lfoliveira08/plant-watering-esp32/docs/Project1_Code_and_Sensor_Guide.docx

ENGR 4399 ST: Cyber-Physical and IoT Systems

Project 1: Code and Sensor Guide

Automatic Plant Watering System with weather-aware dashboard

A plain-language walkthrough of the hardware, the sensors and every part of the ESP32 program, with real excerpts from the code and worked examples. Written so a teammate who did not write the code can explain it and answer questions at the presentation.

Built by: Luis Oliveira Presenting: [partner name] Instructor: Dr. Okan Çağlayan Date: October 20, 2026

HOW TO USE THIS GUIDE

Part 1 is the story in one page. Read it first and you can present the project.

Part 2 explains each sensor and part. Part 3 walks through the code in the order the program runs. Part 4 follows full scenarios with timelines. Part 5 is a question-and-answer sheet. Part 6 is a glossary.

Green boxes give you words to say out loud. Orange boxes are worked examples. Grey boxes are real code from the file RealHardware_Dashboard.ino.

Contents

- Part 1: The project in one page
- Part 2: The hardware and sensors explained
- Part 3: The code, section by section
- Part 4: Worked scenarios (timelines)
- Part 5: Questions you may be asked
- Part 6: Glossary and quick reference

# Part 1: The project in one page

## What it does

A small ESP32 computer reads how wet the soil is. When the soil is too dry, it turns on a pump through a relay and waters the plant. It then waits for the water to spread, checks that the soil actually got wetter, and stops. It will not water if the tank is empty (the pump would run dry) or if rain is coming (the rain will water the plant). It shows its status on a small screen and on a web dashboard, and a buzzer warns if the temperature is bad for the plant.

SAY IT LIKE THIS

“Our system is a small cyber-physical system. It senses the soil moisture and the water level, decides using a state machine, and acts by switching a pump. On top of that it checks the weather forecast, judges the temperature for the selected plant, and has a dashboard with simulation buttons so we can show every safety behavior live.”

## The idea came from a video, and we extended it

The basic concept (soil sensor, relay and small pump) is inspired by the Instagram video “Automatic Plant Watering System” by eazytronic3795. We say this out loud and it is in the report. What we added:

- Tank-level interlock so the pump never runs dry
- Hysteresis (start and stop thresholds), an 8-second pump limit and a soak wait
- Response check and a FAULT latch if the pump or sensor seems broken
- Weather forecast: skip watering if rain is likely
- Three plant profiles: how much water each plant wants and its healthy temperature range
- Temperature alert on the screen, dashboard and buzzer
- A web dashboard with five simulation buttons

## The five-step loop, every half second

1. Read the soil sensor and the water-level sensor (averaged to remove noise).
2. Convert the soil reading to a percentage using the calibration.
3. Decide with the state machine: IDLE, WATERING, SOAKING or FAULT.
4. Act: switch the relay (pump) and the buzzer.
5. Show: update the OLED screen and answer dashboard requests.

## Numbers worth remembering

Item | Value
Soil sensor reading | about 0 in air, about 1500 in water (reads LOW when dry)
Soil percent | raw value divided by 15 (1500 raw = 100%)
Basil / Aloe / Fern: start watering below | 40% / 15% / 50%
Basil / Aloe / Fern: stop at | 70% / 35% / 80%
Tank is LOW below | raw 300 (counts as refilled above 450)
Longest pump run | 8 seconds (BOOT button test: 5 seconds)
Soak wait (demo) | 30 seconds
Fault | after 3 failed cycles, cleared only by pressing EN
Rain blocks watering at | 60% rain chance or more in the next 3 hours
Weather refresh | every 10 minutes
Relay | ACTIVE-HIGH: pin HIGH = relay ON

# Part 2: The hardware and sensors explained

## 2.1 Two ideas you need first

### Sensors and actuators

A sensor measures the physical world and turns it into an electrical signal (soil moisture, water level). An actuator does something in the physical world when told to (the pump, the buzzer). The ESP32 sits in the middle: it reads sensors, decides, and drives actuators. That loop of sensing, deciding and acting on the physical world is what “cyber-physical” means.

### Analog readings and the ADC

Our two sensors give an analog signal, a voltage that changes smoothly. The ESP32 cannot use a voltage directly, so its ADC (analog-to-digital converter) turns it into a number. We use 12-bit resolution, which means numbers from 0 to 4095 for a voltage from about 0 V to 3.3 V. In the code this is the line analogReadResolution(12); in setup().

EXAMPLE

A raw reading of 1500 is about 1500 / 4095 x 3.3 V = 1.2 V. A raw reading of 0 is about 0 V.

The ESP32’s ADC is not perfectly straight, so we do not trust a formula from a data sheet. We calibrate with real readings: sensor in air, sensor in water, and write those numbers in the code.

### Why the sensor pins are D34 and D35

The ESP32 has two ADC groups. ADC2 stops working while Wi-Fi is on. ADC1 (pins 32 to 39) keeps working. D34 and D35 are ADC1, and they are input-only, which is fine for sensors. We use Wi-Fi for the weather and dashboard, so this choice matters.

## 2.2 Soil moisture sensor (Keyestudio, resistive)

Item | Detail
What it is | A small board with two exposed metal probes (prongs) that go into the soil
Pins | S = signal, V = power, G = ground (printed under the pins)
Our wiring | S to D34, V to 3V3, G to GND
Output type | Analog voltage, read by the ADC
Measured values | About 0 in air, about 1500 in water

### How it works

Wet soil conducts electricity better than dry soil. The two probes act like a variable resistor: more water means less resistance between them. The board turns that into a voltage on the signal pin. More water gives a higher voltage and a higher number.

SAY IT LIKE THIS

“The probe measures how easily electricity flows through the soil between two prongs. Water makes that easier, so wetter soil gives a higher reading.”

### The lesson: this sensor reads LOW when dry

Many tutorials use the YL-69 sensor, which reads high when dry. Ours is the opposite: about 0 in air and about 1500 in water. Code copied from those tutorials would be backwards. We avoided this by measuring our own two points and converting with them:

static const int SOIL_RAW_DRY = 0;

static const int SOIL_RAW_WET = 1500;

static float soilPercentFromRaw(int raw) {

float pct = 100.0f * (raw - SOIL_RAW_DRY) / (float)(SOIL_RAW_WET - SOIL_RAW_DRY);

return constrain(pct, 0.0f, 100.0f);

}

Code: calibration constants and the raw-to-percent function.

EXAMPLE

Raw 750 → 100 x (750 − 0) / (1500 − 0) = 50%

Raw 300 → 20%. Raw 1500 → 100%. Raw 1800 (probe in very wet soil) → 130%, which constrain() cuts to 100%.

Because the formula uses the dry and wet numbers, it would still work for a sensor that reads the other way (dry number larger than the wet number).

### Limits to mention honestly

- Resistive probes corrode over time, especially if powered all the time. A capacitive probe lasts longer (future work).
- Readings depend on soil type and salts, so the percent is a useful guide, not a lab measurement.
- Wet soil reads lower than a glass of water. The 100% is “probe in water,” so a healthy wet pot may read 60 to 80%, which is why the thresholds are tunable per plant.

## 2.3 Water level sensor (Keyestudio)

Item | Detail
What it is | A board with a row of parallel exposed traces; the more of them are under water, the higher the reading
Pins | S = signal, V = power, G = ground
Our wiring | S to D35, V to 3V3, G to GND
Output type | Analog, read by the ADC (no on/off output)
Measured values | About 0 when dry; tank counts as LOW below raw 300

It works on the same principle as the soil sensor: water bridges the traces and changes the signal. We mount it standing in the tank with its lowest trace a little above the pump. When the water drops below the sensor, the reading falls under 300 and the tank is LOW, which blocks the pump before it can run dry.

### Hysteresis on the tank

Water ripples and the reading wobbles. If we used one cut-off, the tank status could flicker between OK and LOW. So we use two: LOW below 300, but only OK again above 300 + 150 = 450.

static const int LEVEL_LOW_RAW = 300;

static const int LEVEL_HYST_RAW = 150;

if (levelRaw < LEVEL_LOW_RAW) realTankLow = true;

else if (levelRaw > LEVEL_LOW_RAW + LEVEL_HYST_RAW) realTankLow = false;

tankLow = realTankLow || simTank;

Code: tank threshold with hysteresis. The last line combines the real tank with the dashboard simulation.

EXAMPLE

Water falls: 520 → 380 → 290 (now LOW) → 320 (still LOW) → 420 (still LOW).

Refill: 460 (above 450 → OK again).

Readings between 300 and 450 keep whatever status was already set.

## 2.4 Relay module (Elegoo, 1 channel, 5 V)

The ESP32 pins give only a tiny current and 3.3 V, far too little to run a pump. A relay is an electrically controlled switch: a small signal from the ESP32 magnetizes a coil, which closes a separate switch (the contacts) that carries the pump current. The two circuits are electrically separate, so the pump supply never flows through the ESP32.

Relay part | Connected to | Purpose
Header S (signal) | D26 | The ESP32 tells the relay on or off
Header + / − | VIN (5 V) / GND | Power for the relay coil and its board
Screw COM (common) | Pump supply (+) | Incoming power for the pump
Screw NO (normally open) | Pump red wire | Open when the relay is off, closed when on
Pump black wire | Pump supply (−) | Return path of the pump circuit

We use NO (normally open) so that when the relay is off or the ESP32 is unpowered, the pump is off. That is the safe default.

### Active-HIGH vs active-LOW (our lesson)

Some relay modules turn on when the pin is LOW (active-low), others when it is HIGH (active-high). We first assumed active-low, as many blue modules are. A small test sketch with the pump disconnected showed ours is active-HIGH. The code has a setting for this so one line adapts it:

static const bool RELAY_ACTIVE_LOW = false; // measured: this relay is ACTIVE-HIGH

static void relayWrite(bool on) {

if (RELAY_FLOAT_WHEN_OFF && RELAY_ACTIVE_LOW) {

// (open-drain option for other relay modules)

}

pinMode(PIN_RELAY, OUTPUT);

bool level = RELAY_ACTIVE_LOW ? !on : on;

digitalWrite(PIN_RELAY, level ? HIGH : LOW);

}

Code: relayWrite() turns “on” or “off” into the right pin level for this relay.

EXAMPLE

relayWrite(true) with RELAY_ACTIVE_LOW = false → level = true → pin HIGH → relay clicks ON → pump runs.

If the relay had been active-low: level = !on = false → pin LOW. The rest of the program never needs to know.

## 2.5 Submersible pump

A small DC motor sealed so it can run underwater, with a tube to the plant. It must be fully under water while running (water also cools it). It runs from its own supply through the relay. Do not run it dry: that is the reason for the water-level sensor and the 8-second limit.

## 2.6 OLED display (SSD1306, 0.96 inch, I2C)

A 128 by 64 pixel screen. I2C is a two-wire bus: SDA carries data and SCL carries the clock. Many devices can share the same two wires, each with an address; this one is 0x3C. Wiring: SDA to D21, SCL to D22, VCC to 3V3, GND to GND. The code uses the Adafruit SSD1306 and GFX libraries to draw text and shapes.

Row (pixel y) | What is drawn
0 | Plant profile name (left) and temperature (right)
11 | “Soil NN%” in large text
30 to 38 | Moisture bar with two tick marks (start and stop thresholds) below it at y 40
45 | State and pump: e.g. “IDLE Pump:off”
56 | Most important message: FAULT, TANK LOW, RAIN, TEMP alert, CHECK PUMP, or “Tank OK”

## 2.7 Active buzzer

An active buzzer has its own tone generator inside: apply power and it beeps. So the code only switches it on and off (one pin, D27). A passive buzzer would need us to generate the tone. We make two different alert sounds by changing the on/off pattern (explained in Part 3).

## 2.8 BOOT button

The ESP32 board has a BOOT button wired to pin 0. We reuse it as a manual pump test: hold it and the pump runs for up to 5 seconds, only if the tank has water. It is wired with INPUT_PULLUP, so the pin reads HIGH normally and LOW when pressed. Do not hold it while pressing EN or the board enters upload mode.

## 2.9 The ESP32 and the “virtual sensor”

The ESP32 is a small computer with Wi-Fi. It runs the program, reads the sensors, drives the relay and buzzer, joins Wi-Fi, fetches the weather and serves the dashboard. The weather forecast works like a third sensor: it tells the program the outdoor temperature and the rain chance, even though no physical device measures it.

## 2.10 Pin summary

ESP32 pin | Connected to | Direction | Why this pin
D34 | Soil sensor S | Input (analog) | ADC1, works with Wi-Fi
D35 | Level sensor S | Input (analog) | ADC1, works with Wi-Fi
D26 | Relay signal | Output | Safe general-purpose pin
D27 | Buzzer | Output | General-purpose pin
D21 / D22 | OLED SDA / SCL | I2C | Default I2C pins
D0 | BOOT button | Input (pull-up) | Built into the board
3V3 | Sensors, OLED power | Power | Sensors are 3.3 V logic
VIN (5 V) | Relay module power | Power | Relay coil needs 5 V

# Part 3: The code, section by section

The file RealHardware_Dashboard.ino is about 570 lines. It reads top to bottom in this order: settings, data, helper functions, weather, dashboard, network, display, control logic, then setup() and loop(). The excerpts below are copied from the real file.

## 3.1 The big picture: setup() once, loop() forever

Every Arduino program has two main functions. setup() runs once at power-up. loop() then repeats forever. Our loop() never waits with delay(). Instead it keeps checking the clock (millis(), milliseconds since power-up) and does each job when its time comes. This is called non-blocking design: the web page stays responsive while the pump logic runs.

void loop() {

static uint32_t lastSample = 0;

static int lastRelay = -1;

uint32_t now = millis();

server.handleClient();

updatePrime(now);

if (now - lastSample >= SAMPLE_MS) { lastSample = now; sampleAndControl(now); }

// ...

updateAlert(now);

// ...

}

Code: loop() in outline. Sensors and control run every SAMPLE_MS = 500 ms; the web server and buzzer are serviced on every pass.

SAY IT LIKE THIS

“The program never freezes waiting. Every half second it reads the sensors and runs the decision logic, and in between it keeps answering the web dashboard and the buzzer.”

## 3.2 Libraries (the #include lines)

Library | What we use it for
Wire.h | I2C communication with the OLED
WiFi.h | Join the router or create our own network
WebServer.h | Serve the dashboard page and its small API
ESPmDNS.h | Lets you type plantwater.local instead of an IP address
HTTPClient.h | Ask the weather service for data
Adafruit_GFX.h, Adafruit_SSD1306.h | Draw text and shapes on the OLED

## 3.3 Settings you can change (the constants)

All behavior numbers are in one block at the top so nothing is buried in the logic. static const means the value cannot change while the program runs.

static const int RAIN_SKIP_PCT = 60;

static const uint32_t MAX_RUN_MS = 8000;

static const uint32_t SOAK_MS = 30000;

static const float MIN_RISE_PCT = 3.0f;

static const int MAX_FAILED_CYCLES = 3;

static const uint32_t PRIME_MAX_MS = 5000;

static const uint32_t SAMPLE_MS = 500;

Code: the main tuning constants. Times are in milliseconds.

Constant | Meaning | Change it when
RAIN_SKIP_PCT | Rain chance at or above this blocks watering | You want the system more or less cautious about rain
MAX_RUN_MS | Longest single pump run (8 s) | A bigger pot needs a longer run
SOAK_MS | Wait after a run for water to reach the probe (30 s demo) | A real plant: use minutes
MIN_RISE_PCT | Soil must rise this much after a run, or the run counts as failed | Soil responds slowly or quickly
MAX_FAILED_CYCLES | Failed runs before FAULT | Stricter or more forgiving
PRIME_MAX_MS | BOOT button pump limit | Rarely
SAMPLE_MS | How often sensors are read | Rarely

## 3.4 Plant profiles

A struct groups related values into one record. Each profile holds a name, a description, the soil percent to start watering, the percent to stop, and the healthy temperature range. PROFILES[3] is a list of three of them, and profileIdx says which one is selected (0 = Basil).

struct Profile { const char* name; const char* need; float dry; float wet; float tMin; float tMax; };

static const Profile PROFILES[3] = {

{ "Basil", "thirsty", 40.0f, 70.0f, 12.0f, 32.0f },

{ "Aloe", "drought-tolerant", 15.0f, 35.0f, 10.0f, 35.0f },

{ "Fern", "likes moist soil", 50.0f, 80.0f, 16.0f, 27.0f },

};

static uint8_t profileIdx = 0;

static float curDry() { return PROFILES[profileIdx].dry; }

static float curWet() { return PROFILES[profileIdx].wet; }

Code: three profiles and helpers that return the values of the selected one.

EXAMPLE

With Basil selected, watering starts below 40% (raw below 600) and stops at 70% (raw 1050).

Press Aloe on the dashboard: profileIdx becomes 1, so curDry() returns 15 and curWet() returns 35. Nothing else in the code changes, because the logic always asks curDry() and curWet().

To use your own plants, edit the names and numbers in this one table.

## 3.5 State variables: real values and simulated values

The program keeps its current knowledge in variables. The most important is the state (what the system is doing). Notice that for tank, rain, soil and temperature there is a real value and a simulation switch. This is what lets the dashboard buttons override reality without touching the control logic.

enum State : uint8_t { IDLE, WATERING, SOAKING, FAULT };

static State state = IDLE;

static bool realTankLow = false;

static bool tankLow = false; // real OR simulated

static float soilReal = 0, soilShown = 0;

static bool simRain = false, simTank = false, simSoil = false;

static uint8_t simTemp = 0; // 0 off, 1 too high, 2 too low

Code: the state and the simulation switches.

State | Meaning
IDLE | Soil is fine, or soil is dry but something blocks watering
WATERING | Pump is on
SOAKING | Pump is off while water spreads to the probe
FAULT | Pump disabled after repeated failures; only the EN reset clears it

## 3.6 Helper functions

### readAveraged(): smoothing the noise

A single ADC reading jumps around a little. We read many times quickly and take the average (16 readings for soil, 8 for the tank). This is a simple low-pass filter.

static int readAveraged(int adcPin, int samples) {

long acc = 0;

for (int i = 0; i < samples; i++) { acc += analogRead(adcPin); delayMicroseconds(200); }

return (int)(acc / samples);

}

Code: add up the readings and divide by how many.

EXAMPLE

Four readings 748, 752, 751, 749 add up to 3000; 3000 / 4 = 750, which is 50% soil. One bad spike of 900 would be softened to about 782 instead of jumping straight to 60%.

### Effective values: where simulations are applied

Instead of using the real values directly, the logic asks for the “effective” value: the simulated one if a simulation is on, otherwise the real one.

static float effectiveTemp() {

if (simTemp == 1) return curTMax() + 8.0f;

if (simTemp == 2) return curTMin() - 8.0f;

return weatherTemp;

}

static int effectiveRain() { return simRain ? 100 : weatherRain; }

static bool rainBlock() { int r = effectiveRain(); return r >= RAIN_SKIP_PCT; }

// 0 unknown, 1 OK, 2 too high, 3 too low

static uint8_t tempStatus() {

float t = effectiveTemp();

if (isnan(t)) return 0;

if (t > curTMax()) return 2;

if (t < curTMin()) return 3;

return 1;

}

Code: effective temperature, rain and the temperature verdict.

EXAMPLE

Basil is selected (healthy 12 to 32 °C). “Temp too high” simulated → effective temperature = 32 + 8 = 40 °C → tempStatus() returns 2 (too high) → alert.

Real weather 27 °C → returns 1 (OK). No weather data yet (NaN) → returns 0 (unknown), so no false alarm.

Rain simulated → effectiveRain() = 100 → rainBlock() true. Real forecast 20% → false.

### setState() and the event log

Every change of state goes through setState(), which writes a line to the Serial Monitor and to a small ring buffer of the last 8 events that the dashboard shows. It also records the time of the change, so the program can measure how long it has been in a state.

static void setState(uint8_t s, const char* why) {

char b[80];

snprintf(b, sizeof b, "%s -> %s: %s", STATE_NAME[state], STATE_NAME[s], why);

logEvent(b);

state = (State)s;

stateSince = millis();

}

Code: one place where the state changes and is recorded.

EXAMPLE

Dashboard event log line: IDLE -> WATERING: soil dry. This is how you can explain to the audience exactly why something happened.

## 3.7 Weather: fetchWeather()

The ESP32 sends a web request to the free Open-Meteo service. The reply is text in a format called JSON. Instead of a heavy JSON library, we search for two known labels in the text and read the number after each. If Wi-Fi is not connected, the function does nothing.

String url = String("http://api.open-meteo.com/v1/forecast?latitude=") + LATITUDE + "&longitude=" + LONGITUDE +

"&current=temperature_2m&hourly=precipitation_probability&forecast_hours=3&timezone=auto";

HTTPClient http;

http.setTimeout(4000);

http.begin(url);

int code = http.GET();

Code: building the request. It asks for the current temperature and the rain probability for the next 3 hours at our latitude and longitude.

A simplified picture of the reply, and how the code reads it:

{ ... "current":{"time":"...","interval":900,"temperature_2m":27.4},

... "hourly":{"time":[...],"precipitation_probability":[10,20,35]} }

Shape of the answer (example values).

int c = body.indexOf("\"current\":{");

if (c >= 0) {

int t = body.indexOf("\"temperature_2m\":", c);

if (t >= 0) { weatherTemp = body.substring(t + 17).toFloat(); ok = true; }

}

Code: find “current”, then “temperature_2m” after it, then read the number that follows (17 characters later).

while (i < (int)body.length() && body[i] != ']') {

if (isDigit(body[i])) { int v = body.substring(i).toInt(); if (v > best) best = v; while (isDigit(body[i])) i++; }

else i++;

}

Code: walk through the three rain percentages and keep the largest (“best”).

EXAMPLE

Reply says rain probability [10,20,35] → the code keeps 35. If it were [10,20,70], it keeps 70, which is at or above 60, so rainBlock() becomes true.

Why the maximum? If rain is likely at any point in the next 3 hours, watering now is wasteful.

Schedule: after a good reply the next request is in 10 minutes (600000 ms); after a failure, in 30 seconds. In loop(), weather is fetched only when the pump is not running, because a request can block for a few seconds and we never want the network to delay the pump limits.

SAY IT LIKE THIS

“Every ten minutes the ESP32 asks a free weather service for the temperature and the rain chance. If rain is likely, the pump is blocked, because the rain will water the plant.”

## 3.8 The dashboard: a web page served by the ESP32

The ESP32 is a tiny web server. When your phone or laptop opens plantwater.local, the ESP32 sends back one HTML page that is stored inside the program (the long block named PAGE). That page contains JavaScript that, once per second, asks the ESP32 for the latest status and redraws the screen. Buttons call small web addresses (the API) to change things.

Address | What it does
/ | Sends the dashboard page
/api/status | Returns all current values as JSON (soil, state, pump, tank, rain, temperature, profile, events, simulation flags)
/api/sim?name=rain&val=1 | Turns a simulation on or off (names: rain, tank, soil, temp, clear)
/api/profile?id=1 | Selects a plant profile
/api/mute | Silences the buzzer
/api/weather | Asks for a weather refresh now

refresh();setInterval(refresh,1000);

static void handleSim() {

String n = server.arg("name");

int v = server.arg("val").toInt();

if (n == "clear") { simRain = simTank = simSoil = false; simTemp = 0; logEvent("SIM: all simulations cleared"); }

else if (n == "rain") { simRain = v; logEvent(v ? "SIM: heavy rain forecast injected" : "SIM: rain forecast cleared"); }

// ... tank, soil, temp work the same way

server.send(200, "text/plain", "ok");

}

Code: the page refreshes every second (line 1); handleSim() receives a button press.

EXAMPLE

You press Rain forecast. Chain of events:

1. The browser calls /api/sim?name=rain&val=1.

2. handleSim() sets simRain = true and logs an event.

3. Within half a second, sampleAndControl() sees rainBlock() is true. If the pump is running, the state goes WATERING → IDLE, and the relay is switched off in loop().

4. The next /api/status reply says rainblock:true, and the dashboard shows “BLOCKED - rain will water it”.

NOTE FOR QUESTIONS

The simulations only change what the program believes about rain, tank, soil and temperature. They cannot turn off the 8-second limit, the tank interlock or the fault latch. The dashboard has no password and uses plain HTTP, which is fine for a classroom demo but would need a login and HTTPS in a real product.

## 3.9 Joining Wi-Fi: startNetwork()

At power-up the ESP32 tries to join the router for up to 12 seconds. If that fails, it creates its own Wi-Fi network called “PlantWater” so the dashboard is still reachable (at 192.168.4.1), but weather is then unavailable and only the simulations work. It also registers the name plantwater.local, which is why that address worked even when the IP address changed.

WiFi.mode(WIFI_STA);

if (strlen(WIFI_SSID) > 0) {

WiFi.begin(WIFI_SSID, WIFI_PASS);

uint32_t t0 = millis();

while (WiFi.status() != WL_CONNECTED && millis() - t0 < WIFI_TIMEOUT_MS) { delay(300); Serial.print("."); }

}

if (WiFi.status() == WL_CONNECTED) {

ipText = WiFi.localIP().toString();

apMode = false;

} else {

WiFi.disconnect(); WiFi.mode(WIFI_AP);

WiFi.softAP(AP_SSID, AP_PASS);

apMode = true;

}

if (MDNS.begin("plantwater")) Serial.println("Also reachable at http://plantwater.local");

Code: try the router, fall back to our own network, register the plantwater.local name.

SAY IT LIKE THIS

“If the Wi-Fi is not available, the system does not fail. It creates its own network so we can still use the dashboard and the simulations.”

## 3.10 Manual pump test: updatePrime()

static void updatePrime(uint32_t now) {

static uint32_t start = 0;

static bool held = false;

if (digitalRead(PIN_PRIME) == LOW) {

if (!held) {

held = true; start = now;

}

primeOn = !tankLow && (now - start < PRIME_MAX_MS);

} else { held = false; primeOn = false; }

}

Code: while BOOT is pressed the pump may run, up to 5 seconds, and never with a low tank.

held remembers that the press already started, so the 5 seconds are counted from the first moment, not from every pass of the loop. Releasing the button resets it.

## 3.11 The screen: drawScreen()

The OLED is redrawn after each sample. The bottom line shows only the single most important message, chosen by priority: FAULT first, then tank low, then rain, then temperature alerts, then check-pump, then the soak countdown.

oled.drawRect(0, 30, 128, 9, SSD1306_WHITE);

oled.fillRect(1, 31, (int)(126.0f * soilShown / 100.0f), 7, SSD1306_WHITE);

oled.drawFastVLine((int)(1 + 126.0f * curDry() / 100.0f), 40, 3, SSD1306_WHITE);

oled.drawFastVLine((int)(1 + 126.0f * curWet() / 100.0f), 40, 3, SSD1306_WHITE);

if (state == FAULT) oled.print("FAULT - press EN");

else if (tankLow) oled.print("TANK LOW - REFILL");

else if (rainBlock()) oled.print("RAIN - WATERING OFF");

else if (ts == 2) oled.print("TEMP TOO HIGH!");

else if (ts == 3) oled.print("TEMP TOO LOW!");

Code: the moisture bar, its threshold ticks and the message priority.

EXAMPLE

Soil 50%: the bar is filled 126 x 50 / 100 = 63 pixels wide. For Basil, tick marks sit at x = 1 + 126 x 40 / 100 = 51 (start) and x = 1 + 126 x 70 / 100 = 89 (stop).

Tank low and rain at once: the screen shows “TANK LOW - REFILL” because it ranks higher.

## 3.12 The heart of the program: sampleAndControl()

Twice a second this function does the whole job: read, convert, update the tank status, run the state machine and update the screen. First the reading:

soilRaw = readAveraged(PIN_SOIL, 16);

levelRaw = readAveraged(PIN_LEVEL, 8);

soilReal = soilPercentFromRaw(soilRaw);

soilShown = simSoil ? max(0.0f, curDry() - 10.0f) : soilReal; // "soil too dry" simulation

Code: read both sensors; soilShown is the real percent unless “Soil too dry” is pressed.

EXAMPLE

Basil selected and “Soil too dry” pressed → soilShown = 40 − 10 = 30%, below the 40% start threshold, so watering starts (if tank OK and no rain).

Aloe: 15 − 10 = 5%. Fern: 50 − 10 = 40%.

Then the state machine. Read each case as “if I am in this state, what makes me leave it?”

### IDLE

case IDLE:

if (soilShown < curDry() && !tankLow && !rb) { soilAtStart = soilShown; setState(WATERING, "soil dry"); }

break;

Code: start watering only if soil is dry AND the tank has water AND rain is not expected.

### WATERING

case WATERING:

if (tankLow) {

evalPending = false; setState(IDLE, "tank low - pump stopped");

} else if (rb) {

evalPending = false; setState(IDLE, "rain expected - pump stopped");

} else if (soilShown >= curWet()) {

failedCycles = 0; noResponse = false; evalPending = false; cycles++;

setState(SOAKING, "target moisture reached");

} else if (now - stateSince >= MAX_RUN_MS) {

evalPending = !simSoil; // a simulated reading cannot prove or disprove the pump

cycles++;

setState(SOAKING, "max run time reached");

}

break;

Code: four ways to leave WATERING, checked in priority order.

Order matters: safety first (tank low, rain), then success (target reached), then the time limit. evalPending means “when the soak ends, check whether the soil actually got wetter.” It is cleared when stopping for the tank or rain because that is not a pump failure.

### SOAKING

case SOAKING:

if (now - stateSince >= SOAK_MS) {

if (evalPending) {

evalPending = false;

if (soilShown - soilAtStart < MIN_RISE_PCT) {

failedCycles++; noResponse = true;

} else { failedCycles = 0; noResponse = false; }

}

if (failedCycles >= MAX_FAILED_CYCLES) setState(FAULT, "too many failed cycles - press EN after fixing");

else setState(IDLE, "soak finished");

}

break;

Code: after the soak, did the soil rise by at least 3 points? If not, count a failure; at 3 failures go to FAULT.

### FAULT

case FAULT:

break;

Code: nothing leaves FAULT. Only pressing the EN (reset) button restarts the program.

SAY IT LIKE THIS

“FAULT is deliberately a dead end. If the pump ran three times and the soil never got wetter, something is physically wrong, a person has to look at it and press reset. The system will not keep pumping on its own.”

From | To | Condition
IDLE | WATERING | soil below start % and tank OK and no rain
WATERING | IDLE | tank low, or rain expected (not counted as a failure)
WATERING | SOAKING | soil reached stop %, or 8 s maximum run
SOAKING | IDLE | 30 s soak finished (soil rose at least 3 points, or still under 3 failures)
SOAKING | FAULT | third failed cycle (soil did not rise)
FAULT | (none) | only EN reset

## 3.13 The buzzer: updateAlert()

This function turns the temperature verdict into a sound. It uses the remainder of the clock divided by 2000 ms, so the pattern repeats every two seconds without delays.

bool want = false;

if ((ts == 2 || ts == 3) && !muted) {

uint32_t ph = now % 2000;

if (ts == 2) want = (ph < 150) || (ph >= 300 && ph < 450); // two short beeps = too hot

else want = (ph < 700); // one long beep = too cold

}

buzzing = (ts == 2 || ts == 3) && !muted;

buzzerWrite(want);

Code: two short beeps per 2 s for hot; one long beep per 2 s for cold.

EXAMPLE

now % 2000 is the position inside the current 2-second window. Too hot: beep during 0 to 150 ms, silent until 300 ms, beep 300 to 450 ms, then silent until 2000 ms. Too cold: beep during 0 to 700 ms, silent the rest.

Pressing Silence buzzer sets muted. It clears automatically when the temperature status changes, so a new alert will sound again.

## 3.14 setup() and the last line of loop()

The very first line of setup() turns the relay off. Before Wi-Fi, before the screen, before anything else, the pump is guaranteed off. This matters because an ESP32 pin can float or glitch during startup.

void setup() {

relayWrite(false); // pump OFF first

pinMode(PIN_BUZZER, OUTPUT); buzzerWrite(false);

pinMode(PIN_PRIME, INPUT_PULLUP);

Serial.begin(115200);

analogReadResolution(12);

Wire.begin(PIN_SDA, PIN_SCL);

oledOk = oled.begin(SSD1306_SWITCHCAPVCC, OLED_ADDR);

Code: the start of setup(); pump off first.

The relay is switched in exactly one place, at the end of loop(). All the safety rules are combined in one expression, so there is no other path that can turn the pump on:

int wantOn = ((state == WATERING && !tankLow && !rainBlock()) || primeOn) ? 1 : 0;

if (wantOn != lastRelay) { relayWrite(wantOn); lastRelay = wantOn; }

Code: the single decision point for the pump. The relay is only touched when the wanted value changes.

state is WATERING | tank low | rain blocked | BOOT test (primeOn) | Pump
yes | no | no | no | ON
yes | yes | no | no | off
yes | no | yes | no | off
no (IDLE, SOAKING, FAULT) | any | any | no | off
any | no | any | yes (and ≤ 5 s) | ON (manual test)

SAY IT LIKE THIS

“There is one line that decides whether the pump is on. It is only on if the state machine says WATERING and the tank has water and no rain is expected, or if someone is holding the test button.”

# Part 4: Worked scenarios (timelines)

These use Basil (start below 40%, stop at 70%), tank OK, no rain, and illustrative numbers so you can see the logic in motion. Your real numbers will differ.

## Scenario 1: a normal watering cycle

Time | What happens | State / pump
0 s | Soil reads 25% (raw 375). 25 is below 40, tank OK, no rain. | IDLE → WATERING, relay ON
0 to 8 s | Water flows. Soil climbs, say to 45%, never reaching 70%. | WATERING
8 s | Maximum run time reached. Relay OFF. The code remembers the start was 25%. | SOAKING, pump off
8 to 38 s | Wait 30 s for water to reach the probe. OLED shows a countdown. | SOAKING
38 s | Soil now 48%. Rise = 48 − 25 = 23, which is at least 3, so the cycle succeeded; failed count stays 0. | IDLE
38 s on | 48% is above the 40% start, so no more watering until the soil dries again. | IDLE

## Scenario 2: the tank runs empty mid-cycle

Time | What happens | State / pump
0 s | Soil dry, tank OK → pump starts. | WATERING
3 s | Water falls below the sensor: level raw drops under 300 → tank LOW. | WATERING
3.5 s | Next sample: tankLow is true → stop. evalPending is cleared, so this is not counted as a failure. | IDLE, pump off
after | OLED shows “TANK LOW - REFILL”. Pump stays blocked until the reading rises above 450 after a refill. | IDLE

## Scenario 3: rain simulation

Step | What happens
1 | Soil is dry and the pump is running (state WATERING).
2 | You press Rain forecast. simRain = true, effective rain = 100%, rainBlock() = true.
3 | Within half a second: WATERING → IDLE with the reason “rain expected - pump stopped”. The relay turns OFF.
4 | Dashboard shows “BLOCKED - rain will water it”; OLED shows “RAIN - WATERING OFF”.
5 | Press the button again or Clear all: rain block ends; if the soil is still dry the system starts watering.

## Scenario 4: broken pump or pinched tube → FAULT

Cycle | What happens | Failed count
1 | Pump runs 8 s but no water reaches the soil. After the 30 s soak the soil rose 0 points (less than 3). OLED: “CHECK PUMP / TUBE”. | 1
2 | Soil still dry, so it waters again: same result. | 2
3 | Same result. Failed count reaches 3. | 3 → FAULT
After | State FAULT, pump off, OLED “FAULT - press EN”. About 114 s have passed (3 x 38 s) and the pump ran 24 s in total. Fix the problem, then press EN. | reset

## Scenario 5: temperature alert

Step | What happens
1 | Basil selected (healthy 12 to 32 °C). You press Temp too high: effective temperature = 40 °C.
2 | tempStatus() = 2. The event log records “ALERT: temperature too high”. The dashboard shows “TOO HIGH for Basil”; OLED line 56 shows “TEMP TOO HIGH!” (if no higher-priority message).
3 | The buzzer plays two short beeps every 2 s.
4 | Press Silence buzzer: sound stops, the alert stays on screen. Switch to Aloe (healthy up to 35 °C): 35 + 8 = 43 °C is still too high, so the alert persists.
5 | Press Clear all: status returns to OK (or to the real weather’s verdict) and “Temperature back in the healthy range” is logged.

# Part 5: Questions you may be asked

Q1. Why use a relay and not connect the pump to the ESP32?

An ESP32 pin supplies a few milliamps at 3.3 V. A pump needs much more current. The relay lets the small signal switch a separate circuit, and keeps the pump supply isolated from the ESP32.

Q2. Why does your soil sensor read low when dry?

This Keyestudio probe is wired so more water gives a higher voltage. Many tutorial sensors (YL-69) are the opposite. We measured about 0 in air and about 1500 in water and used those two numbers, so the percent is always right.

Q3. What is hysteresis and why do you use it?

Two different thresholds, one to start and one to stop (for Basil 40% and 70%). With a single threshold the pump would switch on and off rapidly around that value. We also use it for the tank level (300 and 450).

Q4. Why limit the pump to 8 seconds?

Protection against an empty tank, a stuck sensor or a pinched tube. Without a limit, a failure could flood the plant or burn out the pump.

Q5. What happens if the tank is empty?

The level sensor reads below 300, the tank is LOW, the pump is blocked and stopped, and the screen says TANK LOW. It is not counted as a pump failure. It resumes after a refill (above 450).

Q6. What happens if Wi-Fi goes down?

Watering keeps working from the soil and tank logic. Weather becomes unknown, so rain cannot block watering. At startup, if the router is not found, the ESP32 creates its own network so the dashboard and simulations still work.

Q7. Where does the weather data come from?

The free Open-Meteo service, every 10 minutes, for the university’s location. We use the current temperature and the highest rain probability in the next 3 hours.

Q8. Is the temperature measured at the plant?

No. It is the forecast outdoor temperature for the location. A temperature sensor at the plant is the natural stage 2 improvement. This is a stated limitation.

Q9. Are the simulation buttons cheating?

No. They inject a condition on top of the real readings so we can show rain, a low tank, dry soil and temperature alerts on demand, without waiting for real rain. The safety limits still apply and the page says when a simulation is active.

Q10. What is FAULT and how do you recover?

After three failed cycles (pump ran, soil did not get wetter) the system stops pumping and shows FAULT. Only the physical EN reset button clears it, so a person must inspect the hardware first.

Q11. How did you calibrate the sensors?

We printed the raw ADC values with the soil probe in air and in water (about 0 and about 1500) and put them in SOIL_RAW_DRY and SOIL_RAW_WET. For the tank, we noted the reading at the lowest acceptable water level and set LEVEL_LOW_RAW to 300.

Q12. Why are the sensors on D34 and D35?

They are ADC1 pins, which keep working while Wi-Fi is on. ADC2 pins do not.

Q13. Why a state machine?

It makes the behavior predictable and testable: four clear states, and exactly one condition list for leaving each. It is easy to explain and to check against the test table.

Q14. What was the mistake with the relay?

We assumed active-low like many blue relay modules. A relay-only test with the pump disconnected showed it is active-high. Testing parts alone before connecting the pump avoided surprises.

Q15. Why does a resistive probe corrode?

Current flows through the metal in wet soil, which slowly eats the prongs. Capacitive sensors have no exposed metal in contact with the soil and last longer.

Q16. What about security?

The dashboard has no login and uses plain HTTP, acceptable for a classroom demo. A real product needs a login, HTTPS, no simulation interface, and signed firmware updates. The simulations cannot disable the safety limits.

Q17. Can the pump be turned on manually?

Yes, by holding the BOOT button on the board for up to 5 seconds. It is a deliberate override for someone physically at the device, used to prime the tube, and it still refuses to run with a low tank.

Q18. What is next (stage 2)?

A temperature and humidity sensor at the plant, a grow light, plant profiles stored on the device, a login and HTTPS, and a capacitive soil probe, building toward the Smart Greenhouse.

Q19. What did you add compared with the video that inspired you?

Tank interlock, hysteresis with run limit and soak, response check and fault latch, OLED status, weather forecast, temperature alert with buzzer, three plant profiles and the dashboard with simulations.

# Part 6: Glossary and quick reference

Term | Plain meaning
ESP32 | Small computer chip with Wi-Fi and Bluetooth; the brain of the project
Sensor / actuator | Measures the world / does something in the world
ADC | Analog-to-digital converter; turns a voltage into a number (0 to 4095 here)
Raw value | The number straight from the ADC before conversion to percent
Calibration | Measuring known points (air, water) so raw numbers can be turned into real units
Hysteresis | Different thresholds for starting and stopping so a system does not flicker
State machine | A program organized as a set of states with rules for moving between them
Relay | Electrically controlled switch; lets a small signal control a bigger circuit
Active-HIGH | The relay turns on when the control pin is HIGH
COM / NO / NC | Relay screws: common, normally open, normally closed
I2C | Two-wire bus (SDA data, SCL clock) used for the OLED
Interlock | A safety rule that blocks an action under unsafe conditions (empty tank)
Latch | A condition that stays set until deliberately reset (FAULT until EN)
Soak | Waiting time after watering for the water to reach the sensor
millis() | Milliseconds since the ESP32 started; used for timing without delay()
Non-blocking | Code that never waits idle, so other jobs keep running
JSON | Text format for data, used by the weather service and the dashboard API
API | A set of web addresses a program can call to get or change data
mDNS | Lets you use a name like plantwater.local instead of an IP address
EN | The reset button on the ESP32 board
BOOT | Button on the board; reused as the manual pump test

## Quick changes (where to edit)

I want to… | Edit this
Use another Wi-Fi | WIFI_SSID and WIFI_PASS near the top, then upload again
Change a plant’s thresholds or name | The PROFILES table
Make the soak longer (real plant) | SOAK_MS (for example 10 minutes = 600000)
Change how cautious it is about rain | RAIN_SKIP_PCT
Re-calibrate the soil sensor | SOIL_RAW_DRY and SOIL_RAW_WET after reading raw values in air and water
Change when the tank counts as low | LEVEL_LOW_RAW (and LEVEL_HYST_RAW)
Reverse the relay | RELAY_ACTIVE_LOW
Move the location for weather | LATITUDE and LONGITUDE

Project 1 – Code and Sensor Guide – Automatic Plant Watering System
